Ytuf/multiprobe/hw/multiprobe-pcb/production/bom.csv

Designator | Footprint | Quantity | Value | LCSC Part #
C1, C3 | C0402 | 2 | C10uF | C77000
C10, C21, C9 | 0402 | 3 | C4.7uF | C368809
C11, C12, C13, C14, C15, C16, C17, C18, C19, C22 | C0402 | 10 | 100nf | C1525
C2, C4, C5, C8 | C0402 | 4 | C100nF | C77020
C20 | C0402 | 1 | C4.7uF | C368809
C6, C7 | C0402 | 2 | C15pF | C140684
D1 | POWERDI-123_L2.8-W1.8-LS3.7-RD | 1 | D | C110493
J1 | HDR-TH_3P-P2.54-H-M-BW7.2-P | 1 | DBG_1 | C92159
J11 | HDR-TH_3P-P2.54-H-M-BW7.2-P | 1 | PWR_OUT | C92159
J2 | HDR-TH_3P-P2.54-H-M-BW7.2-P | 1 | UART_1 | C92159
J3 | HDR-TH_3P-P2.54-H-M-BW7.2-P | 1 | DBG_2 | C92159
J4 | HDR-TH_3P-P2.54-H-M-BW7.2-P | 1 | UART_2 | C92159
J5 | HDR-TH_3P-P2.54-H-M-BW7.2-P | 1 | DBG_3 | C92159
J6 | HDR-TH_3P-P2.54-H-M-BW7.2-P | 1 | UART_3 | C92159
J7 | HDR-TH_3P-P2.54-H-M-BW7.2-P | 1 | DBG_4 | C92159
J8 | HDR-TH_3P-P2.54-H-M-BW7.2-P | 1 | UART_4 | C92159
L1 | IND-SMD_L2.0-W1.6_AOTA-B201610S3R3-101-T | 1 | AOTA-B201610S3R3-101-T | C42411119
LED1, LED2, LED3, LED4, LED5, LED6, LED7, LED8 | LED0402-RD | 8 | ~ | C130723
LED9 | LED0402-RD | 1 | ~ | C130719
R1 | R0402 | 1 | R10K | C60490
R10 | R0402 | 1 | 1K | C11702
R11 | R0402 | 1 | R33 | C852729
R12, R14, R15, R16, R17, R18, R19, R20, R21 | R0402 | 9 | R2K | C4109
R2, R6 | R0402 | 2 | R5.1K | C25941
R22, R23, R24, R25, R26, R27, R28, R29, R30, R31, R32, R33, R34, R35, R36, R37 | R0402 | 16 | R100 | C25076
R3 | R0402 | 1 | R5.6K | C25908
R4, R5 | R0402 | 2 | R27 | C25100
R7 | R0402 | 1 | R100K | C60491
R8 | R0402 | 1 | R1K | C25543
SW1, SW2 | KEY-SMD_4P-L4.2-W3.2-P2.20-LS5.1-TL | 2 | ~ | C92589
U1, U2 | D0402-BI | 2 | RCLAMP0521P.TCT_C3029033 | C3029033
U3 | SOT-23-5_L3.0-W1.7-P0.95-LS2.8-BR | 1 | ME6217C33M5G | C427602
U4 | USON-8_L4.0-W3.0-P0.80-BL_WINBOND_UU | 1 | W25Q32JVUUIQ | C2999380
U5 | CRYSTAL-SMD_4P-L3.2-W2.5-BL | 1 | ABM8-272-T3_C20625731 | C20625731
U6 | QFN-60_L7.0-W7.0-P0.40-TL-EP3.4 | 1 | RP2350A_C42411118 | C42411118
USB1 | USB-C-SMD_TYPE-C-6PIN-2MD-073 | 1 | type-c-31-m-12 | C2765186
