Ytuf/multiprobe/sw/testing/multi_uart/README.md

# UART launch examples
Example launch file for selecting each debug interface from the VSCode. Select the Debug menu and then select the following from the "RUN AND DEBUG" dropdown.

### Pico Debug (Cortex-Debug) SWD 1 - UART 1 -> ACM0
- DEBUG 1
- UART 1 -> /dev/ttyACM0

### Pico Debug (Cortex-Debug) SWD 2 - UART 2 -> ACM0
- DEBUG 2
- UART 2 -> /dev/ttyACM0
 
### Pico Debug (Cortex-Debug) SWD 3 - UART 3 -> ACM0
- DEBUG 3
- UART 3 -> /dev/ttyACM0

### Pico Debug (Cortex-Debug) SWD 4 - UART 4 -> ACM0
- DEBUG 4
- UART 4 -> /dev/ttyACM0

### Pico Debug (Cortex-Debug) SWD 1 - UART 1 -> ACM1
- DEBUG 1
- UART 1 -> /dev/ttyACM1

### Pico Debug (Cortex-Debug) SWD 2 - UART 2 -> ACM1
- DEBUG 2
- UART 2 -> /dev/ttyACM1
 
### Pico Debug (Cortex-Debug) SWD 3 - UART 3 -> ACM1
- DEBUG 3
- UART 3 -> /dev/ttyACM1

### Pico Debug (Cortex-Debug) SWD 4 - UART 4 -> ACM1
- DEBUG 4
- UART 4 -> /dev/ttyACM1
