Ytuf/multiprobe/hw/multiprobe-pcb/doc/multiprobe-pcb.pdf

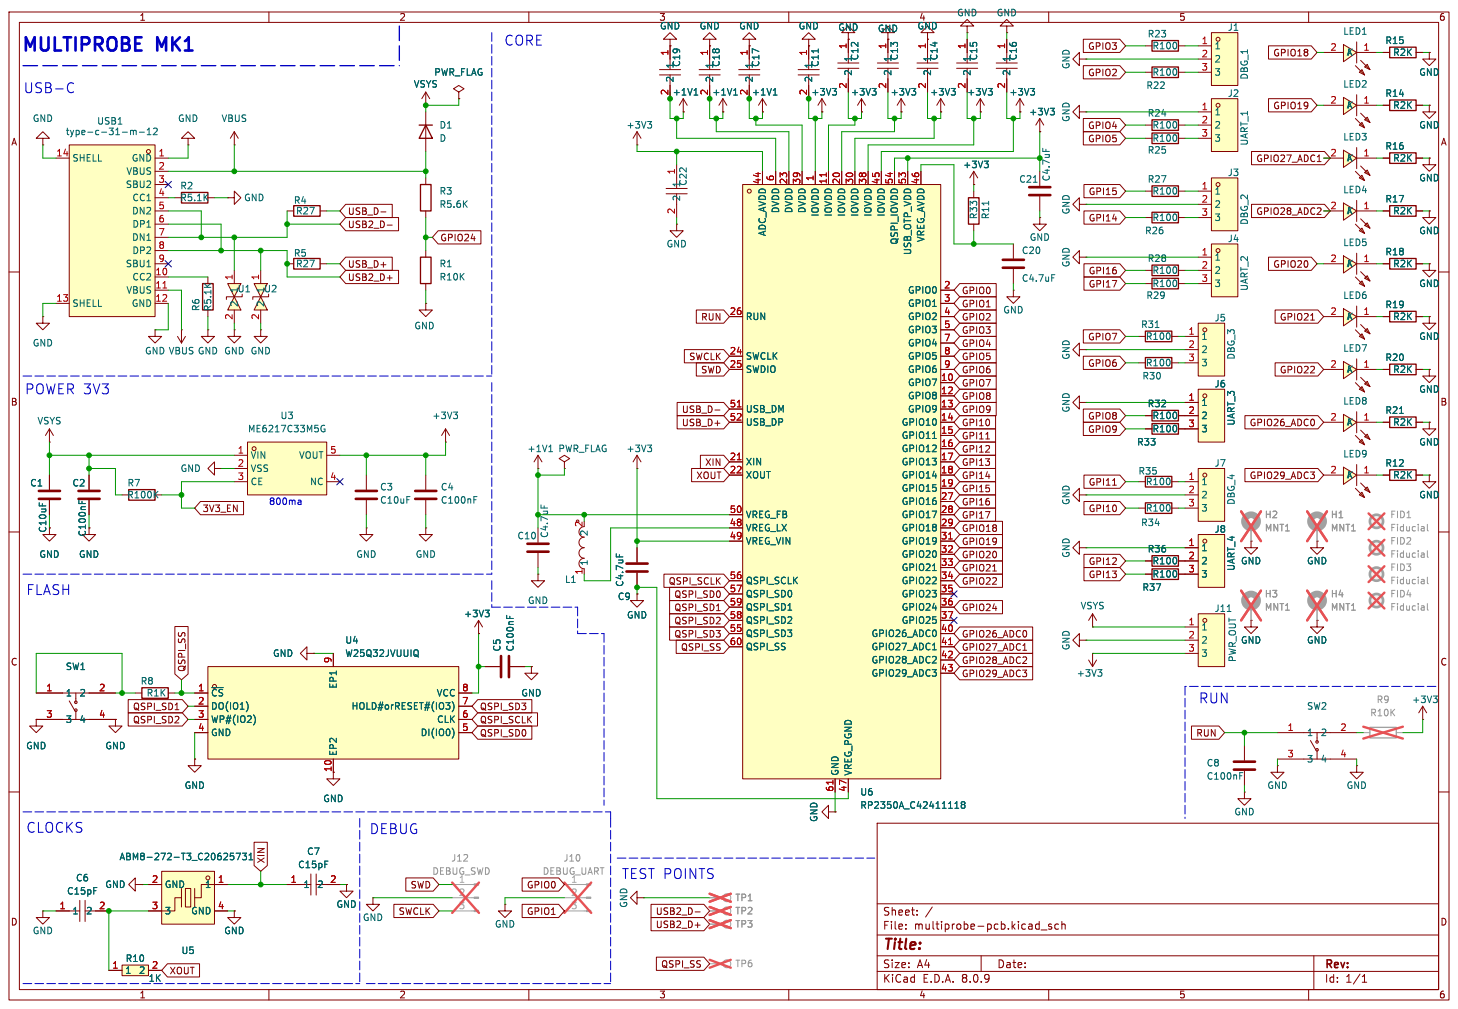
[picture p2: page 1]

2 U2 GND GND 1 CC2 10 VBUS 11 GND 12 SHELL 13 SHELL 14 VBUS 2 SBU2 3 CC1 4 DN2 5 DP1 6 DN1 7 DP2 8 SBU1 9 USB1

1 GPIO7 10 IOVDD 11 GPIO8 12 GPIO9 13 GPIO10 14 GPIO11 15 GPIO12 16 GPIO13 17 GPIO14 18 GPIO15 19 GPIO0 2 IOVDD 20 XIN 21 XOUT 22 DVDD 23 SWCLK 24 SWDIO 25 RUN 26 GPIO16 27 GPIO17 28 GPIO18 29 GPIO1 3 IOVDD 30 GPIO19 31 GPIO20 32 GPIO21 33 GPIO22 34 GPIO23 35 GPIO24 36 GPIO25 37 IOVDD 38 DVDD 39 GPIO2 4 GPIO26_ADC0 40 GPIO27_ADC1 41 GPIO28_ADC2 42 GPIO29_ADC3 43 ADC_AVDD 44 IOVDD 45 VREG_AVDD46 VREG_PGND 47 VREG_LX 48 VREG_VIN 49 GPIO3 5 VREG_FB 50 USB_DM 51 USB_DP 52 USB_OTP_VDD 53 QSPI_IOVDD 54 QSPI_SD3 55 QSPI_SCLK 56 QSPI_SD0 57 QSPI_SD2 58 QSPI_SD1 59 DVDD

Id: 1/1 Title: File: multiprobe-pcb.kicad_sch Sheet: /
