Ytuf/multiprobe/hw/multiprobe-pcb/multiprobe-pcb.kicad_pcb

## KiCad design hw/multiprobe-pcb/multiprobe-pcb.kicad_pcb (2025-09-10)

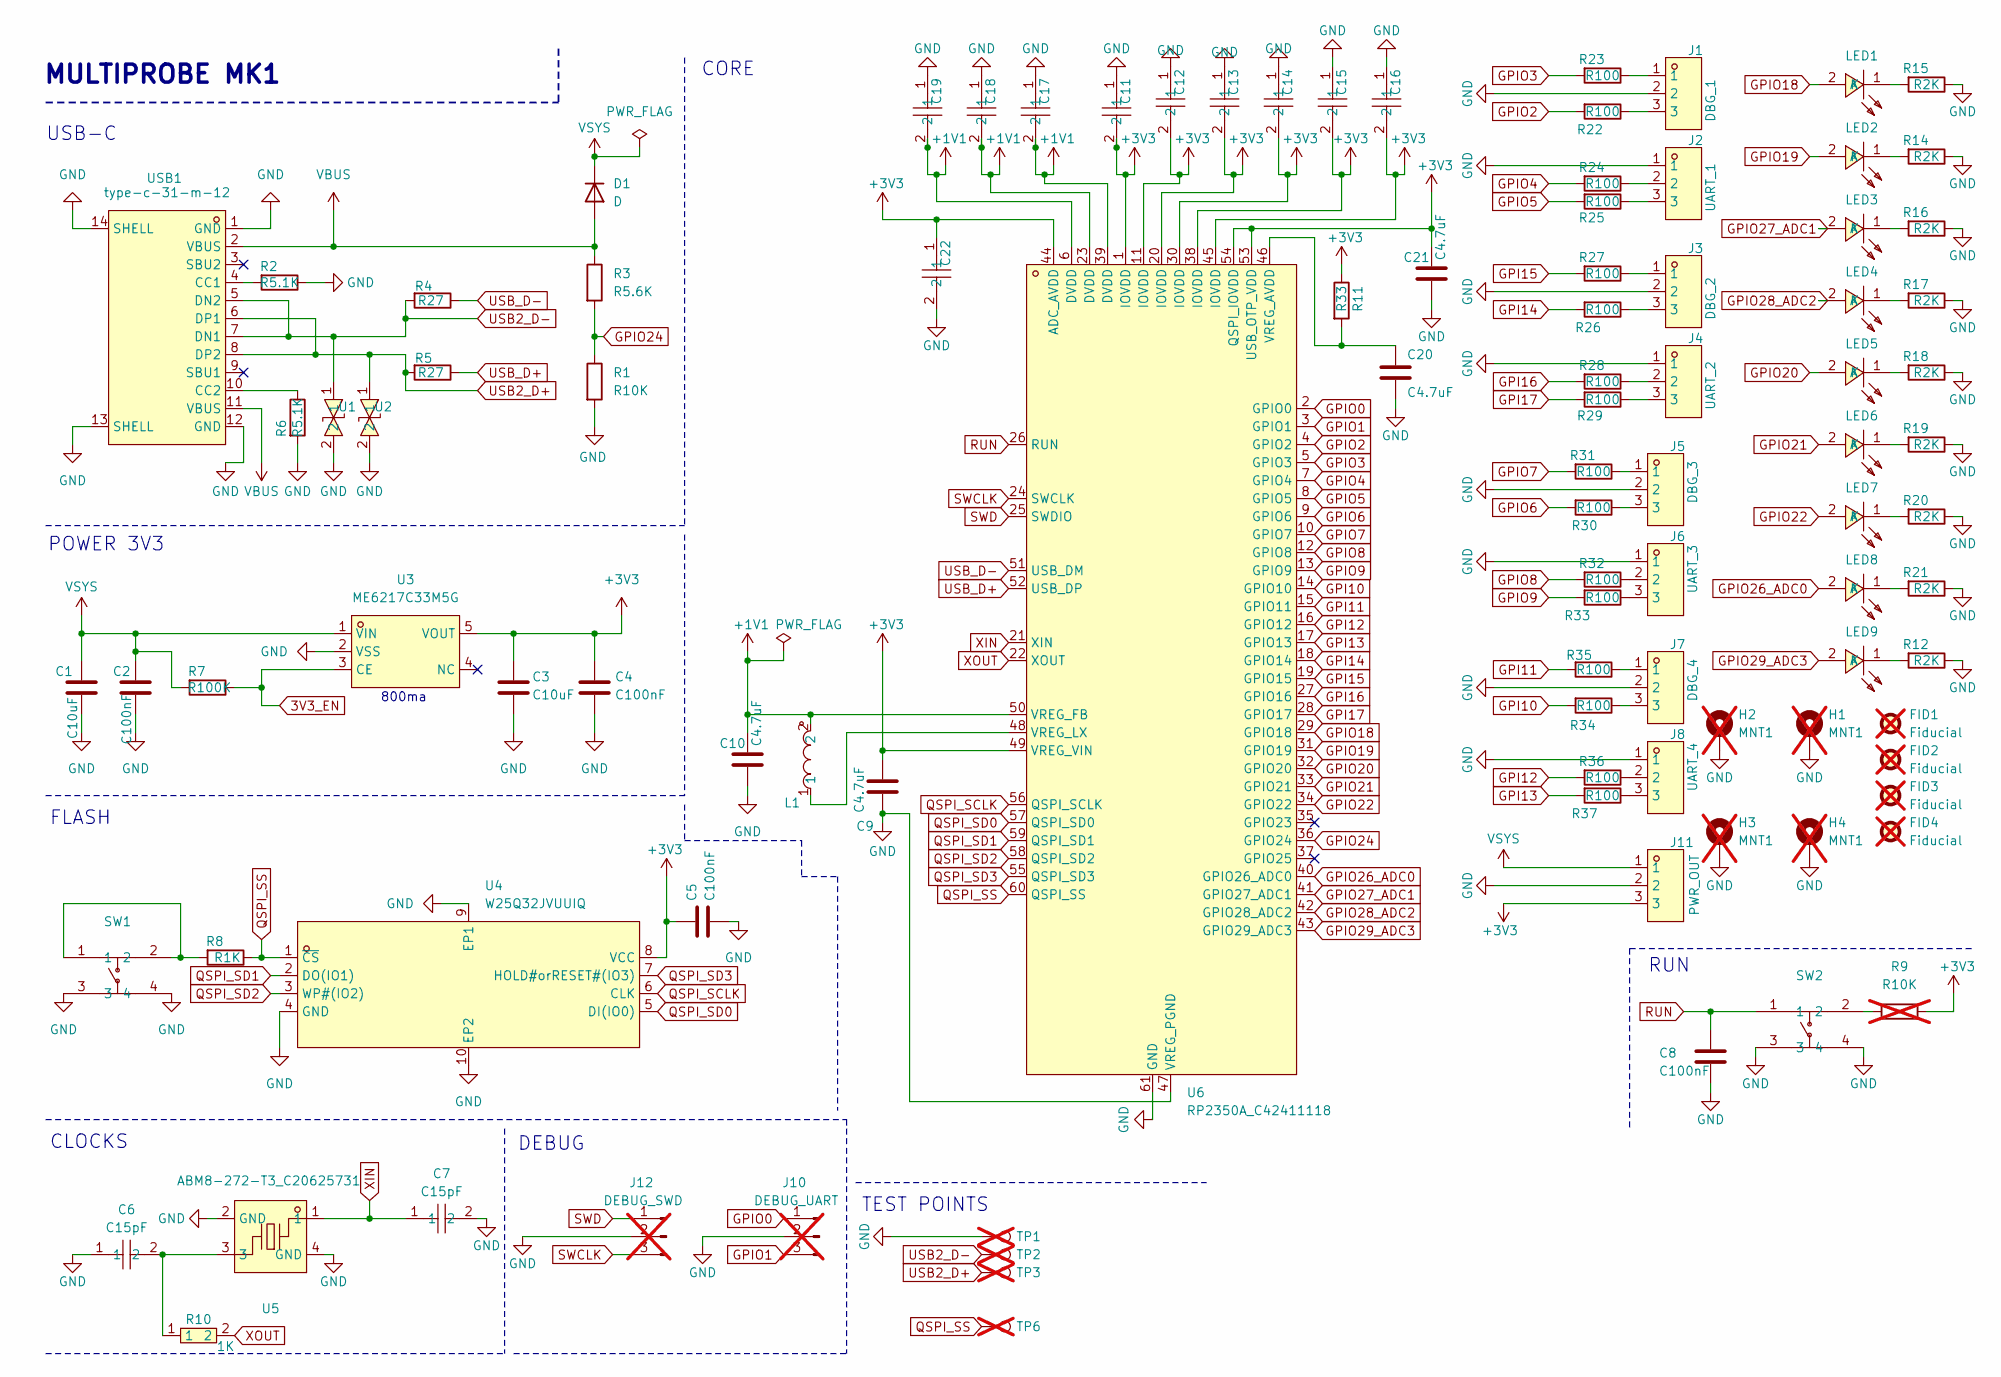
[picture p3: schematic multiprobe-pcb.kicad_sch]

Parts:
C1, C3: C10uF; C0402; LCSC Part C77000
C2, C4, C5, C8: C100nF; C0402; LCSC Part C77020
C6, C7: C15pF; C0402; LCSC Part C140684
C9, C10, C21: C4.7uF; C_0402_1005Metric; LCSC Part C368809
C11, C12, C13, C14, C15, C16, C17, C18, C19, C22: 100nf; C0402; LCSC Part C1525
C20: C4.7uF; C0402; LCSC Part C368809
D1: D; POWERDI-123_L2.8-W1.8-LS3.7-RD; LCSC Part C110493
FID1, FID2, FID3, FID4: Fiducial; Fiducial_1mm_Mask2mm; not fitted
H1, H2, H3, H4: MNT1; MountingHole_2.2mm_M2_DIN965_Pad; not fitted
J1: DBG_1; HDR-TH_3P-P2.54-H-M-BW7.2-P; LCSC Part C92159
J2: UART_1; HDR-TH_3P-P2.54-H-M-BW7.2-P; LCSC Part C92159
J3: DBG_2; HDR-TH_3P-P2.54-H-M-BW7.2-P; LCSC Part C92159
J4: UART_2; HDR-TH_3P-P2.54-H-M-BW7.2-P; LCSC Part C92159
J5: DBG_3; HDR-TH_3P-P2.54-H-M-BW7.2-P; LCSC Part C92159
J6: UART_3; HDR-TH_3P-P2.54-H-M-BW7.2-P; LCSC Part C92159
J7: DBG_4; HDR-TH_3P-P2.54-H-M-BW7.2-P; LCSC Part C92159
J8: UART_4; HDR-TH_3P-P2.54-H-M-BW7.2-P; LCSC Part C92159
J10: DEBUG_UART; PinHeader_1x03_P2.54mm_Vertical; not fitted
J11: PWR_OUT; HDR-TH_3P-P2.54-H-M-BW7.2-P; LCSC Part C92159
J12: DEBUG_SWD; PinHeader_1x03_P2.54mm_Vertical; not fitted
L1: AOTA-B201610S3R3-101-T; IND-SMD_L2.0-W1.6_AOTA-B201610S3R3-101-T; LCSC Part C42411119
LED1, LED2, LED3, LED4, LED5, LED6, LED7, LED8: LED0402-RD; LCSC Part C130723
LED9: LED0402-RD; LCSC Part C130719
R1: R10K; R0402; LCSC Part C60490
R2, R6: R5.1K; R0402; LCSC Part C25941
R3: R5.6K; R0402; LCSC Part C25908
R4, R5: R27; R0402; LCSC Part C25100
R7: R100K; R0402; LCSC Part C60491
R8: R1K; R0402; LCSC Part C25543
R9: R10K; R0402; LCSC Part C60490; not fitted
R10: 1K; R0402; LCSC Part C11702
R11: R33; R0402; LCSC Part C852729
R12, R14, R15, R16, R17, R18, R19, R20, R21: R2K; R0402; LCSC Part C4109
R22, R23, R24, R25, R26, R27, R28, R29, R30, R31, R32, R33, R34, R35, R36, R37: R100; R0402; LCSC Part C25076
SW1, SW2: KEY-SMD_4P-L4.2-W3.2-P2.20-LS5.1-TL; LCSC Part C92589
TP1, TP2, TP3, TP6: TestPoint_Pad_D1.0mm; not fitted
U1, U2: RCLAMP0521P.TCT_C3029033; D0402-BI; LCSC Part C3029033
U3: ME6217C33M5G; SOT-23-5_L3.0-W1.7-P0.95-LS2.8-BR; LCSC Part C427602
U4: W25Q32JVUUIQ; USON-8_L4.0-W3.0-P0.80-BL_WINBOND_UU; LCSC Part C2999380
U5: ABM8-272-T3_C20625731; CRYSTAL-SMD_4P-L3.2-W2.5-BL; LCSC Part C20625731
U6: RP2350A_C42411118; QFN-60_L7.0-W7.0-P0.40-TL-EP3.4; LCSC Part C42411118
USB1: type-c-31-m-12; USB-C-SMD_TYPE-C-6PIN-2MD-073; LCSC Part C2765186

Connections:
3V3_EN: R7.1, U3.3 (CE)
+1V1: C10.1, C17.2, C18.2, C19.2, L1.2, U6.6 (DVDD), U6.23 (DVDD), U6.39 (DVDD), U6.50 (VREG_FB)
+3V3: C3.1, C4.1, C5.1, C9.1, C11.2, C12.2, C13.2, C14.2, C15.2, C16.2, C21.1, C22.1, J11.3, R9.2, R11.1, U3.5 (VOUT), U4.8 (VCC), U6.1 (IOVDD), U6.11 (IOVDD), U6.20 (IOVDD), U6.30 (IOVDD), U6.38 (IOVDD), U6.44 (ADC_AVDD), U6.45 (IOVDD), U6.49 (VREG_VIN), U6.53 (USB_OTP_VDD), U6.54 (QSPI_IOVDD)
GND: C1.2, C2.2, C3.2, C4.2, C5.2, C6.1, C7.2, C8.2, C9.2, C10.2, C11.1, C12.1, C13.1, C14.1, C15.1, C16.1, C17.1, C18.1, C19.1, C20.2, C21.2, C22.2, H1.1, H2.1, H3.1, H4.1, J1.2, J2.1, J3.2, J4.1, J5.2, J6.1, J7.2, J8.1, J10.2, J11.2, J12.2, R1.2, R2.1, R6.2, R12.1, R14.1, R15.1, R16.1, R17.1, R18.1, R19.1, R20.1, R21.1, SW1.3, SW1.4, SW2.3, SW2.4, TP1.1, U1.2, U2.2, U3.2 (VSS), U4.4 (GND), U4.9 (EP1), U4.10 (EP2), U5.2 (GND), U5.4 (GND), U6.47 (VREG_PGND), U6.61 (GND), USB1.1 (GND), USB1.12 (GND), USB1.13 (SHELL), USB1.14 (SHELL)
GPI10: R34.2, U6.14 (GPIO10)
GPI11: R35.2, U6.15 (GPIO11)
GPI12: R36.2, U6.16 (GPIO12)
GPI13: R37.2, U6.17 (GPIO13)
GPI14: R26.2, U6.18 (GPIO14)
GPI15: R27.2, U6.19 (GPIO15)
GPI16: R28.2, U6.27 (GPIO16)
GPI17: R29.2, U6.28 (GPIO17)
GPIO0: J10.1, U6.2 (GPIO0)
GPIO1: J10.3, U6.3 (GPIO1)
GPIO2: R22.2, U6.4 (GPIO2)
GPIO3: R23.2, U6.5 (GPIO3)
GPIO4: R24.2, U6.7 (GPIO4)
GPIO5: R25.2, U6.8 (GPIO5)
GPIO6: R30.2, U6.9 (GPIO6)
GPIO7: R31.2, U6.10 (GPIO7)
GPIO8: R32.2, U6.12 (GPIO8)
GPIO9: R33.2, U6.13 (GPIO9)
GPIO18: LED1.2 (A), U6.29 (GPIO18)
GPIO19: LED2.2 (A), U6.31 (GPIO19)
GPIO20: LED5.2 (A), U6.32 (GPIO20)
GPIO21: LED6.2 (A), U6.33 (GPIO21)
GPIO22: LED7.2 (A), U6.34 (GPIO22)
GPIO24: R1.1, R3.2, U6.36 (GPIO24)
GPIO26_ADC0: LED8.2 (A), U6.40 (GPIO26_ADC0)
GPIO27_ADC1: LED3.2 (A), U6.41 (GPIO27_ADC1)
GPIO28_ADC2: LED4.2 (A), U6.42 (GPIO28_ADC2)
GPIO29_ADC3: LED9.2 (A), U6.43 (GPIO29_ADC3)
unnamed: C6.2, R10.1, U5.3
unnamed: J1.1, R23.1
unnamed: J1.3, R22.1
unnamed: J2.2, R24.1
unnamed: J2.3, R25.1
unnamed: J3.1, R27.1
unnamed: J3.3, R26.1
unnamed: J4.2, R28.1
unnamed: J4.3, R29.1
unnamed: J5.1, R31.1
unnamed: J5.3, R30.1
unnamed: J6.2, R32.1
unnamed: J6.3, R33.1
unnamed: J7.1, R35.1
unnamed: J7.3, R34.1
unnamed: J8.2, R36.1
unnamed: J8.3, R37.1
unnamed: LED1.1 (K), R15.2
unnamed: LED2.1 (K), R14.2
unnamed: LED3.1 (K), R16.2
unnamed: LED4.1 (K), R17.2
unnamed: LED5.1 (K), R18.2
unnamed: LED6.1 (K), R19.2
unnamed: LED7.1 (K), R20.2
unnamed: LED8.1 (K), R21.2
unnamed: LED9.1 (K), R12.2
unnamed: R8.2, SW1.1, SW1.2
unnamed: R9.1, SW2.2
unnamed: C20.1, R11.2, U6.46 (VREG_AVDD)
unnamed: L1.1, U6.48 (VREG_LX)
unnamed: R2.2, USB1.4 (CC1)
unnamed: R6.1, USB1.10 (CC2)
QSPI_SCLK: U4.6 (CLK), U6.56 (QSPI_SCLK)
QSPI_SD0: U4.5 (DI(IO0)), U6.57 (QSPI_SD0)
QSPI_SD1: U4.2 (DO(IO1)), U6.59 (QSPI_SD1)
QSPI_SD2: U4.3 (WP#(IO2)), U6.58 (QSPI_SD2)
QSPI_SD3: U4.7 (HOLD#orRESET#(IO3)), U6.55 (QSPI_SD3)
QSPI_SS: R8.1, TP6.1, U4.1 (~CS), U6.60 (QSPI_SS)
RUN: C8.1, SW2.1, U6.26 (RUN)
SWCLK: J12.3, U6.24 (SWCLK)
SWD: J12.1, U6.25 (SWDIO)
USB2_D+: R5.2, TP3.1, U2.1, USB1.6 (DP1), USB1.8 (DP2)
USB2_D-: R4.2, TP2.1, U1.1, USB1.5 (DN2), USB1.7 (DN1)
USB_D+: R5.1, U6.52 (USB_DP)
USB_D-: R4.1, U6.51 (USB_DM)
VBUS: D1.2 (A), R3.1, USB1.2 (VBUS), USB1.11 (VBUS)
VSYS: C1.1, C2.1, D1.1 (K), J11.1, R7.2, U3.1 (VIN)
XIN: C7.1, U5.1, U6.21 (XIN)
XOUT: R10.2, U6.22 (XOUT)

Notes on the sheet:
RUN
USB-C
800ma
POWER 3V3
TEST POINTS
CLOCKS
CORE
MULTIPROBE MK1
DEBUG
FLASH

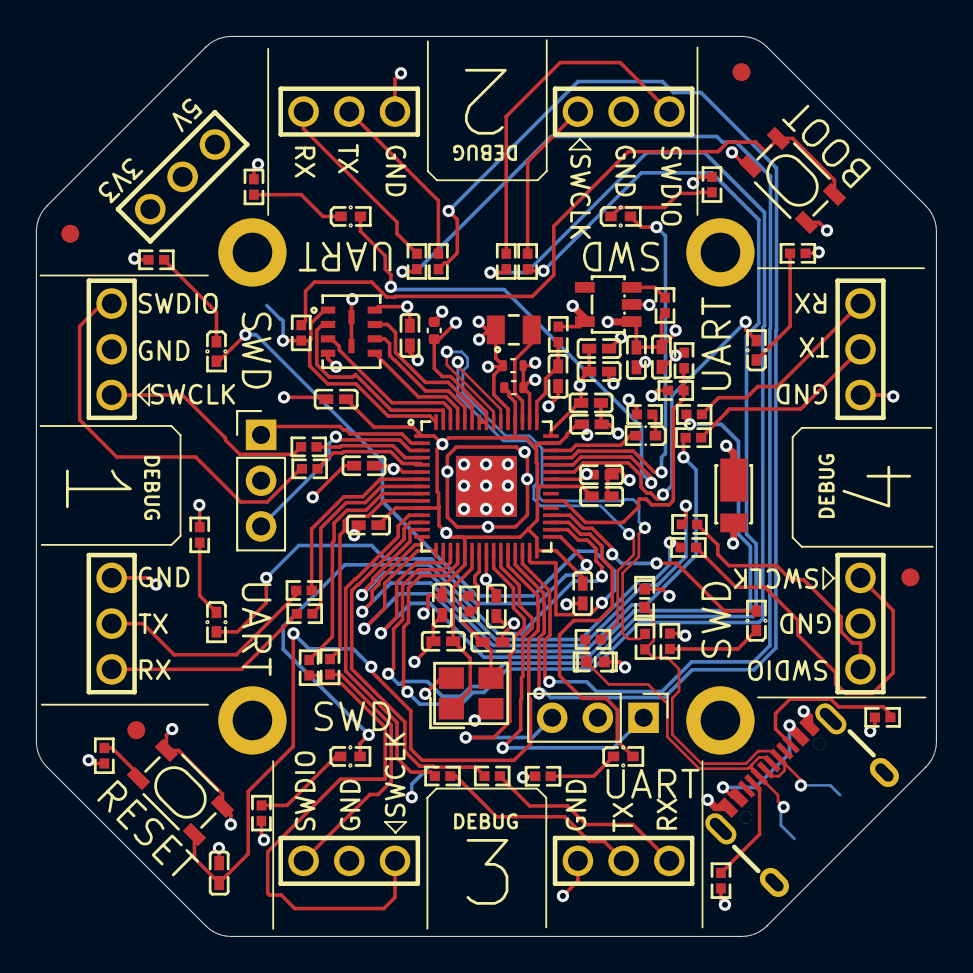
[picture p4: board multiprobe-pcb.kicad_pcb from above]

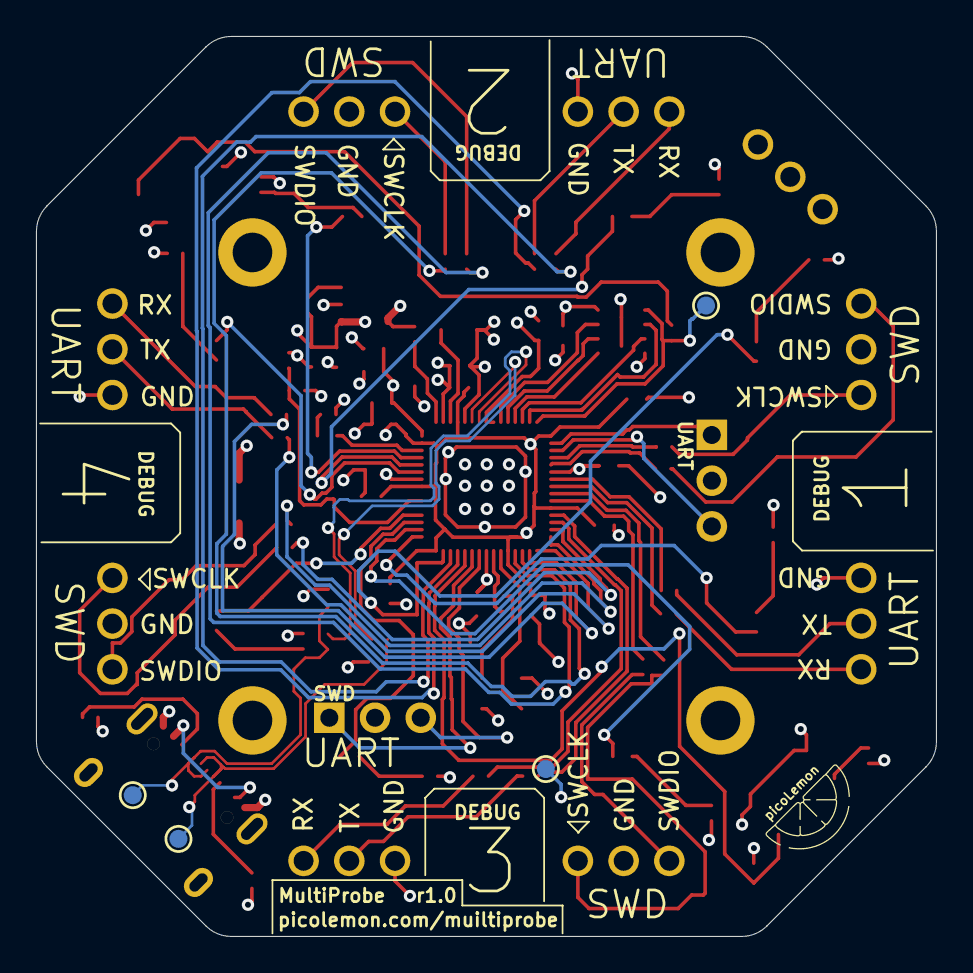
[picture p5: board multiprobe-pcb.kicad_pcb from below]

Board: 4 copper layers, 50.0 x 50.0 mm, 101 parts (4 on the bottom side), 81 nets.
