Ytuf/multiprobe/(commit log)

2025-09-10 Initial release
    [bom.csv, designators.csv, multiprobe-pcb.kicad_pcb, multiprobe-pcb.kicad_sch, positions.csv]
2026-05-18 Audit-driven multiprobe firmware fixes + FreeWili board customization
    Bundles two related changes:
    1. FreeWili board customization (pre-existing local edits)
    - board_multiprobe_config.h: FreeWili pin map (DISPLAY pio0/sm0 GPIO10/11,
    MAIN pio0/sm1 GPIO12/13, WIO-E5 pio1/sm0 GPIO9/8); PROM I2C, status LEDs,
    PIC MCLR pull
    - CMakeLists.txt: target rp2040 (debug processor); link hardware_i2c
    - main.c: PROM I2C init, BOARD_LED, PIC MCLR pull init; guard
    PROBE_USB_CONNECTED_LED block with #ifdef
    - cdc_uart.c: small adjustments
    2. Audit-driven multiprobe firmware fixes (10 issues from a code audit)
    Fix #1 (critical) -- NULL global dap_taskhandle in tud_*_cb
    main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
    [DAP_config.h, board_multiprobe_config.h, cdc_uart.c, main.c, probe.c, probe.h, sw_dp_pio.c, tusb_edpt_handler.c]
2026-05-18 multiprobe: second-wave audit-driven fixes (5 issues)
    Post-commit-1e7c03e audit by three subagents (computer engineering,
    computer science, embedded systems) verified the first 10 fixes and
    surfaced these residuals.
    Fix #11 -- tud_unmount_cb lifecycle hardening (main.c, tusb_edpt_handler.c/h)
    Previously vTaskDelete'd dap_threads synchronously from tud_unmount_cb.
    If the deleted task was inside vTaskSuspendAll (the old dap_thread ring
    block) or holding pio_mutex, the scheduler-suspend counter or the PIO
    mutex would leak permanently. Replaced with a cooperative-exit
    pattern: tud_unmount_cb sets DAPEndpointState::should_exit and notifies
    the task; dap_thread observes the flag at th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
    [DAP_config.h, main.c, probe.c, tusb_edpt_handler.c, tusb_edpt_handler.h]
2026-05-18 multiprobe: third-wave audit fixes -- close Wave-2 lifecycle residuals
    Third-pass audit found that Wave-2's cooperative-exit pattern (Fix #11)
    had introduced two new wedge regressions plus uncovered some pre-existing
    holes. Closing all of them.
    Fix #16a -- tud_mount_cb mount-race wedge (main.c)
    tud_unmount_cb sets should_exit=true and notifies but does not clear
    dap_taskhandle. On a fast re-enumeration (USB hub blip, suspend-resume
    VBUS cycle) tud_mount_cb runs from the same usb_thread before the
    lower-priority dap_thread has been scheduled to observe should_exit.
    tud_mount_cb saw handle != NULL and skipped both task recreation AND
    the should_exit=false reset (the reset was insi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
    [cdc_uart.c, main.c, tusb_edpt_handler.c]
2026-05-18 multiprobe: trim audit-era comments
    Strip the long Fix #N narratives the audit commits left behind. Keep
    WHY-not-obvious one-liners; drop everything that restated the code or
    recapped commit history. -273/+42 lines, no behavior change.
    [DAP_config.h, cdc_uart.c, main.c, probe.c, probe.h, sw_dp_pio.c, tusb_edpt_handler.c]
2026-05-18 multiprobe: fourth-wave audit fixes
    tud_unmount_cb now waits (bounded 100ms/probe) for each dap_thread to
    self-delete before zeroing endpoint addresses. Closes the re-enumeration
    race where the old task could still run while the next mount reset
    state under its feet -- root cause of three separate HIGH bugs found
    in pass-4 audit (probe_init/deinit race, dap_thread writing to zeroed
    ep_addrs, dap_edpt_open resetting ring indices without ring_mutex).
    Defense in depth:
    * probe_init / probe_deinit hold the per-PIO mutex across the
    initted check + body, not just pio_add/remove_program.
    * probe_write_bits / probe_read_bits / probe_hiz_clocks /
    probe_read_mode / probe_write_mode early-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
    [main.c, probe.c, tusb_edpt_handler.h]
2026-05-18 multiprobe: bump DAP_PACKET_SIZE 64 -> 512
    OpenOCD's flash-write path issues DAP_TransferBlock with 21+ transfers
    in a single batch (21*4 + 3 = 87 bytes), exceeding the previous 64-byte
    limit. Result: "CMSIS-DAP transfer count mismatch: expected 21, got 16"
    because Fix #13 truncated the response (correct behavior given the
    buffer, but breaks OpenOCD's progress).
    512 is the standard CMSIS-DAP packet size for WinUSB/bulk; gives ~127
    transfers per packet. SRAM growth is bounded (per-state buffers
    4*512 = 2KB per probe; PROBE_DAP_COUNT=4 -> 8KB net), well within the
    RP2040's 264KB.
    Also shrunk the DAP_Info local scratch buffer from DAP_PACKET_SIZE down
    to 128 bytes (longest CMSIS-DAP info stri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
    [DAP_config.h]
2026-05-18 multiprobe: bump DAP_PACKET_SIZE 512 -> 1024
    OpenOCD still requested 175 transfers in a single block (~703 bytes)
    with the 512-byte buffer. 1024 is the upper bound stock CMSIS-DAP
    probes advertise and gives headroom for ~255 transfers per packet.
2026-05-18 multiprobe: relax DAP_*_Transfer iteration headroom check 16 -> 4
    OpenOCD asked for 255 reads in a 1024-byte packet (255*4 + 2 = 1022,
    fits). Our 16-byte iteration-top guard treated every iteration as
    needing worst-case 16B (post_read drain + new xfer, both TS-tagged)
    and bailed out one iteration early -> "expected 255, got 254" ->
    flash algorithm RAM probe fails -> vFlashErase fails.
    Drop to 4B headroom (minimum a plain data write needs). The per-write
    bounds checks already added by Fix #4 still gate the TS / post_read
    extras individually -- the iteration-top check just needs to ensure
    this iteration's data write can land.
    Applied to both DAP_SWD_Transfer and DAP_JTAG_Transfer for symmetr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
2026-05-22 debugprobe(vscode): add FreeWili-aware launch + task configs
    Document the 4-interface multiprobe slot layout (DISPLAY / MAIN /
    WIO-E5 / unused) and add per-target debug configurations that resolve
    the ELF, GDB, chip, and openocd target via the Raspberry Pi Pico VS
    Code extension placeholders. Includes the `monitor reset init` /
    SMP/FPB workaround note in launch.json.
